Kr1-b/Mecha4.github.io/README.md

# Mecha4.guthub.io
An interesting project about a way a fish moves around using kinematics and mechatronics and more
