Kr1-b/Mecha4.github.io/design.html

Mecha4 Menu

- Simulator
- Design
- Waterproofing
- Files

# Design

A fish-shaped skin around a sealed electronics tube. Every part is a STEP file you can open in Inventor.



Download STEP

## Electronics

Select a block to see what it does.

## What you need

Your kit covers the Arduino, one servo, the leak sensor and the wiring. These are the parts to buy for the fish.

### Electronics

Part | Qty | Have it?
Arduino Uno (or a Nano, which is smaller) | 1 | Kit
MG90S metal-gear micro servo | 2 | Kit has 1 SG90; buy 2 MG90S
N20 gear motor, 6 V, 150–300 rpm, 3 mm D shaft | 1 | Buy
DRV8833 (or L9110S) motor driver | 1 | Buy
2S LiPo 7.4 V, ~1000 mAh, max 70 × 35 × 18 mm, plus charger | 1 | Buy
5 V 3 A UBEC / buck converter | 1 | Buy
FC-28 soil moisture probe (used as a leak sensor) | 1 | Kit
Reed switch + relay module (switch it on with a magnet, no hole) | 1 | Relay in kit; buy reed switch
Jumper wires, resistors, LEDs | — | Kit

### Mechanical

Part | Qty
NBR O-ring 70 mm ID × 2.5 mm (end cap) | 2 + spares
NBR O-ring 3 mm ID × 1.5 mm (shaft glands) | 8 + spares
3 mm stainless rod (file a flat on it for the D-shaft) | 300 mm
3–3 mm rigid shaft coupler (motor to tail shaft) | 1
1.5 mm steel wire for the fin pushrod | 50 mm
M3 screws, M3 heat-set inserts, M3 set screws | ~15 each
3 mm steel pins (or filament) for the seam | 6
Silicone grease, silica gel pack, epoxy coating | —
Ballast: steel nuts or lead shot | ~370 g

### Does it need gears?

No custom gears. The N20 motor and the servos already have gearboxes inside. The crank turns the motor's spin into the tail's back-and-forth swing, and a short pushrod links the fin servo to the fin shaft.

### Which kit parts won't work underwater

The ultrasonic sensor, PIR, IR obstacle sensor and the displays are useful for bench testing only. Ultrasonic and IR don't work through water and the tube wall, and radio barely does either. So run the fish on a pre-programmed swim pattern, or use a thin tether to the kit's joystick.

## How it fits together

The electronics mount on the sled, the sled slides into the dry pod, and the end cap plugs in behind it. The pod drops into the bottom skin half, the top half closes over it, and three screws from the belly hold it shut.

The three moving shafts go in last, from outside: the rudder shaft from the top, the fin cross shaft through both sides and the fin lever, and the tail shaft through the end cap into the crank.

In Inventor: open fish_assembly.step with File → Open to get every part in place. To simulate, add revolute joints on the rudder shaft (vertical), fin shaft (sideways), tail shaft (lengthwise) and tail hinge pin, plus a slot joint between the crank pin and the tail lever.

## Team

Supervised by Dr. Claudio Vignola.

MEC 482 Mechatronics, Abu Dhabi University, Fall 2026 Source on GitHub
