Kr1-b/Mecha4.github.io/fish flapping.gif

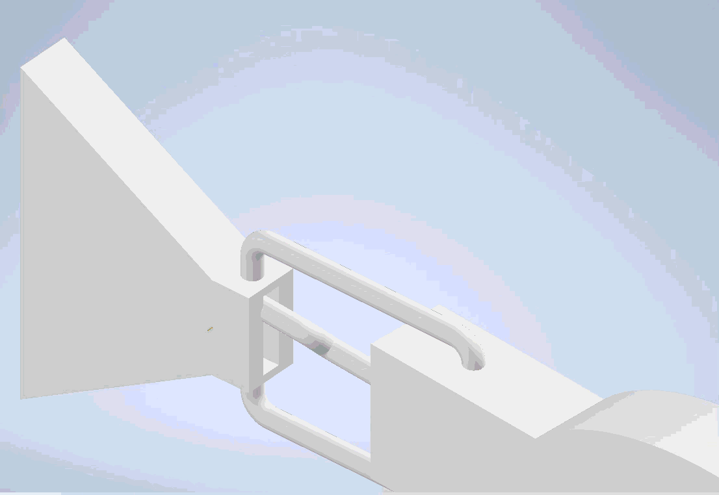
fish flapping.gif
