Kr1-b/Mecha4.github.io/pectoral-fin.png

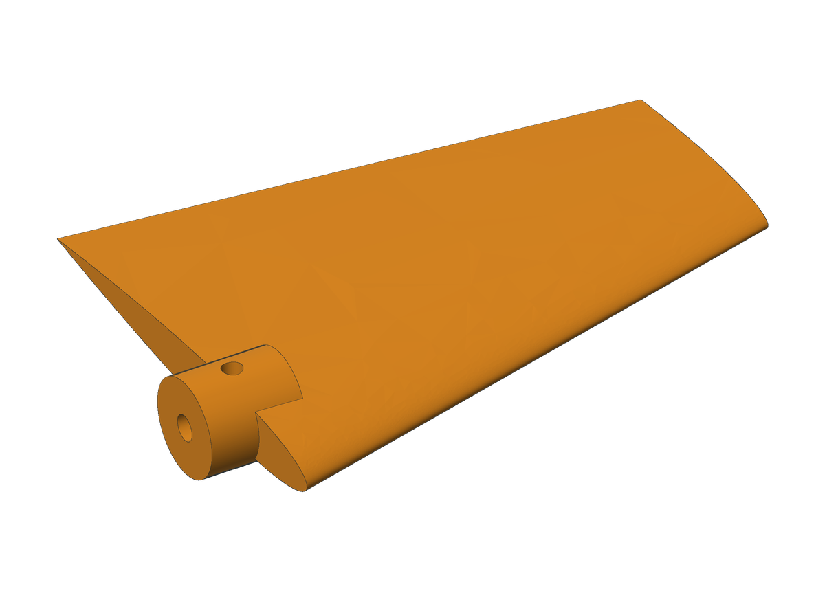
pectoral-fin.png
