Kr1-b/Mecha4.github.io/pectoral_fin_right.step

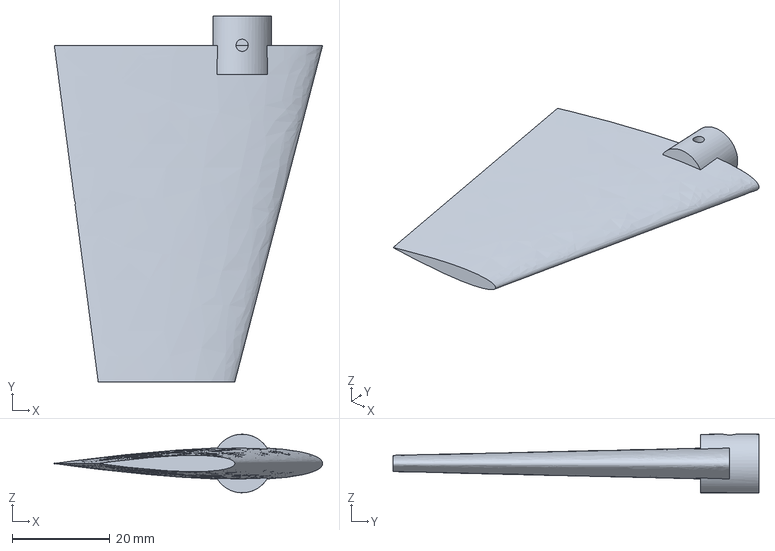
[picture p3: CAD file, 2026-11-05]
pectoral_fin_right.step
55.0 x 75.0 x 12.0 mm
