Kr1-b/Mecha4.github.io/(list of files, cad)

Other CAD files:
pectoral_fin_left.step
pectoral_fin_left.stl
pectoral_fin_right.stl
